craigyjp/Stratus---Pulse/Schematics/Front_Panel_Pots_&_Buttons.pdf

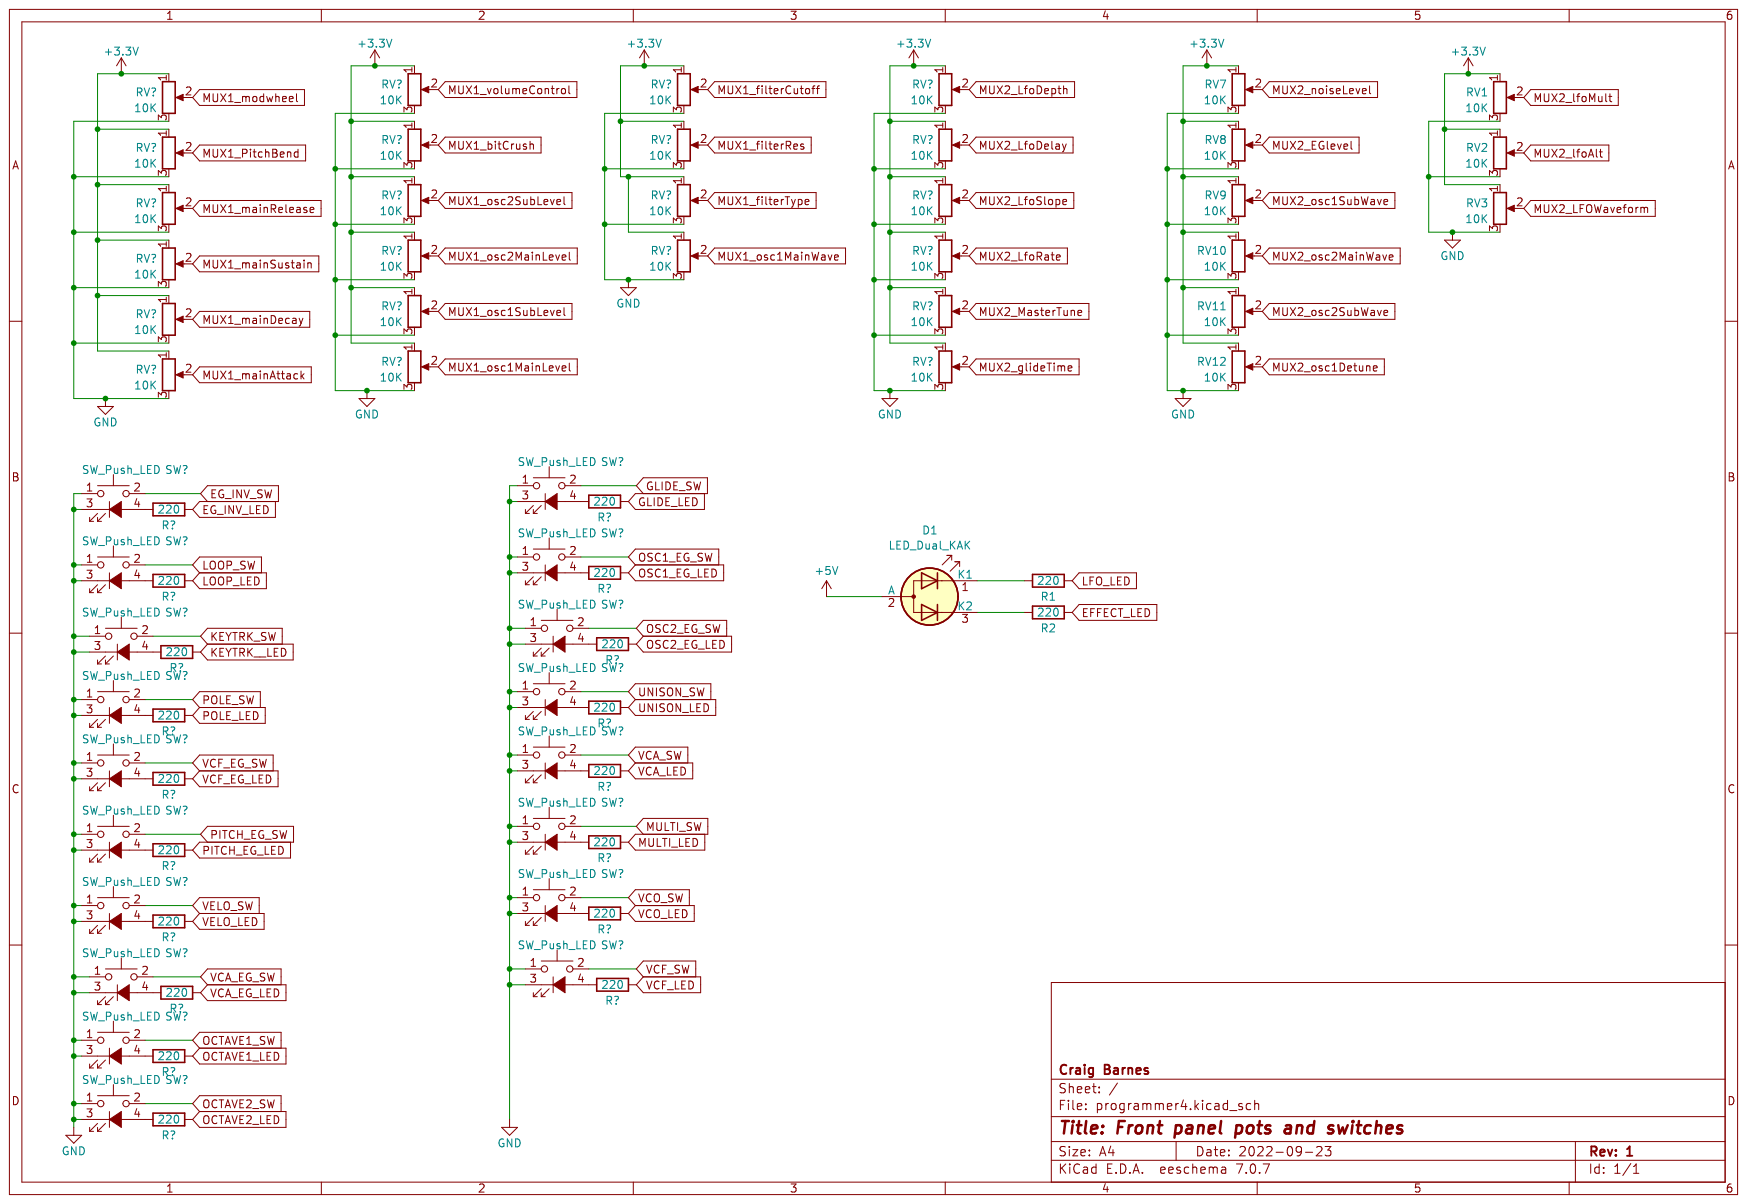
[picture p2: page 1]
