craigyjp/Stratus---Pulse/Schematics/Teensy_programmer.pdf

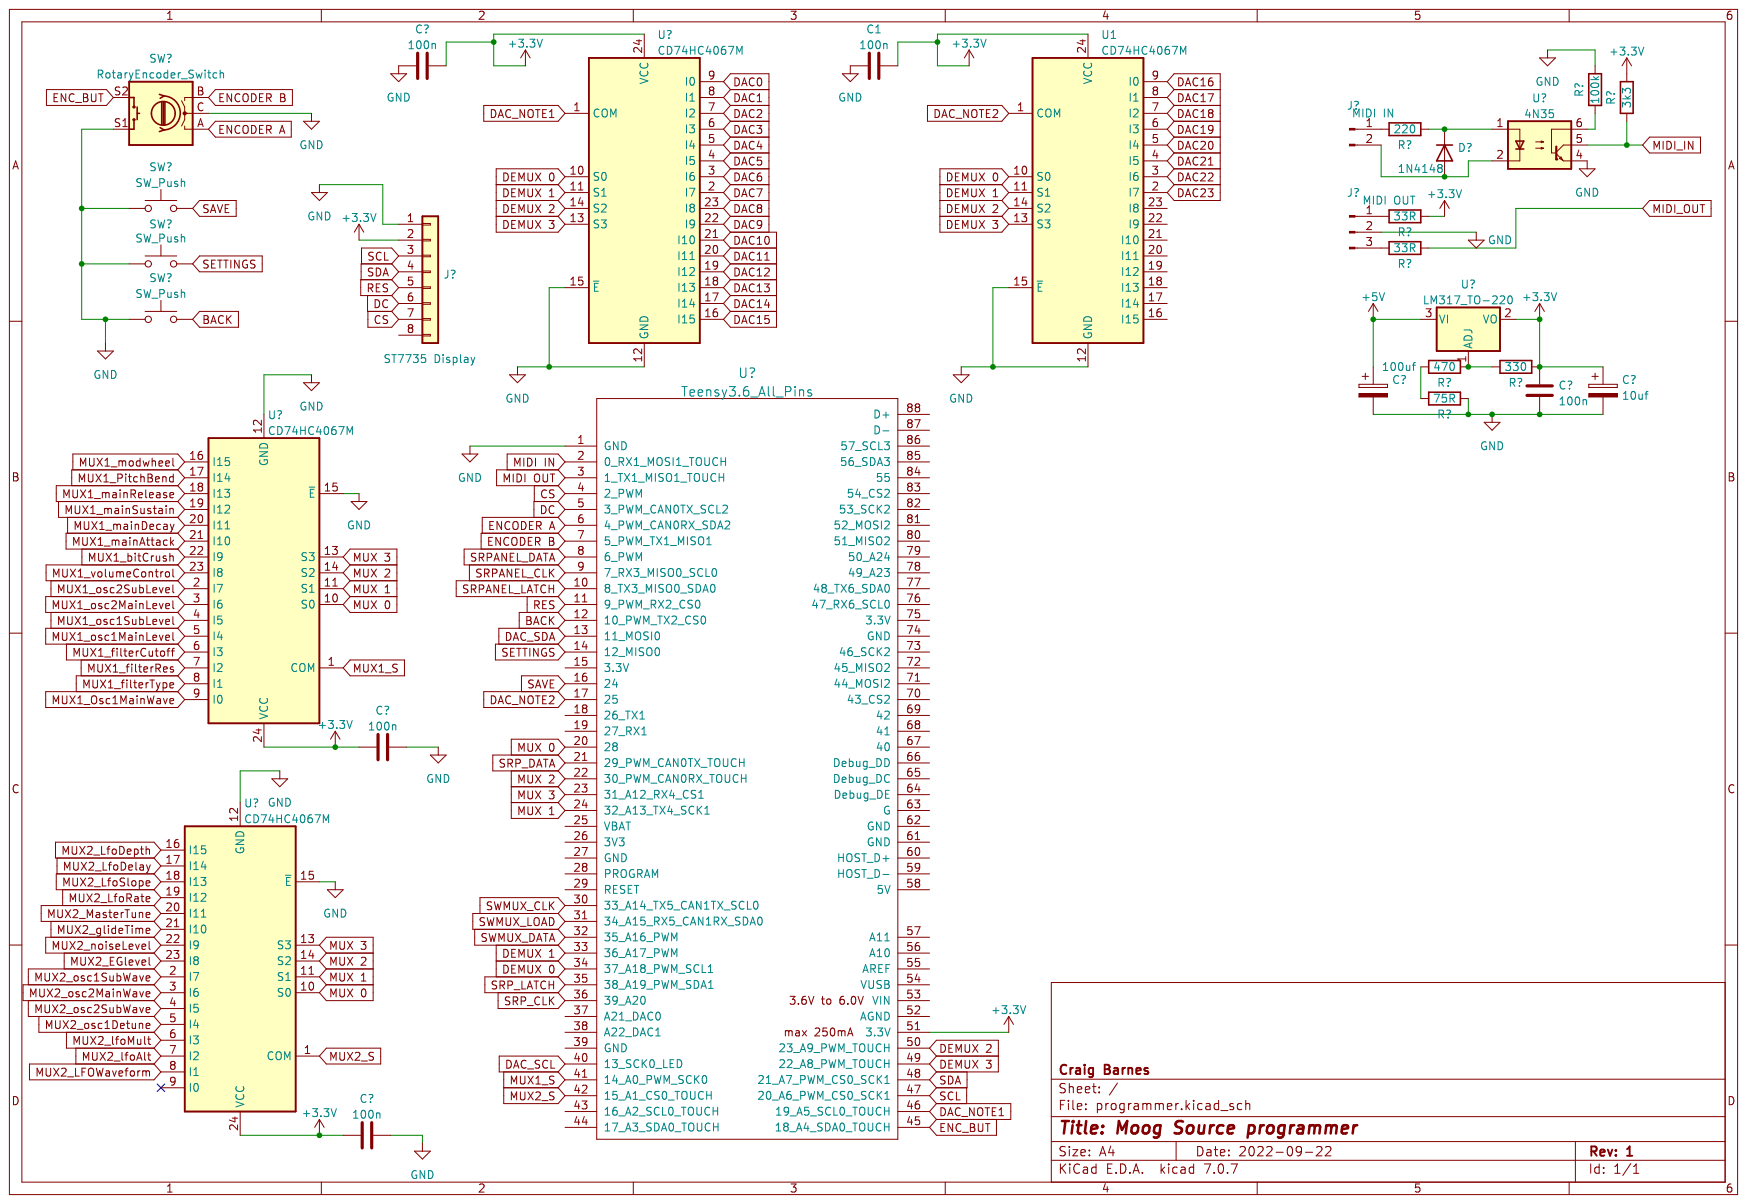
[picture p3: page 1]
