craigyjp/Stratus---Pulse/Schematics/595_&_165_shiftregisters.pdf

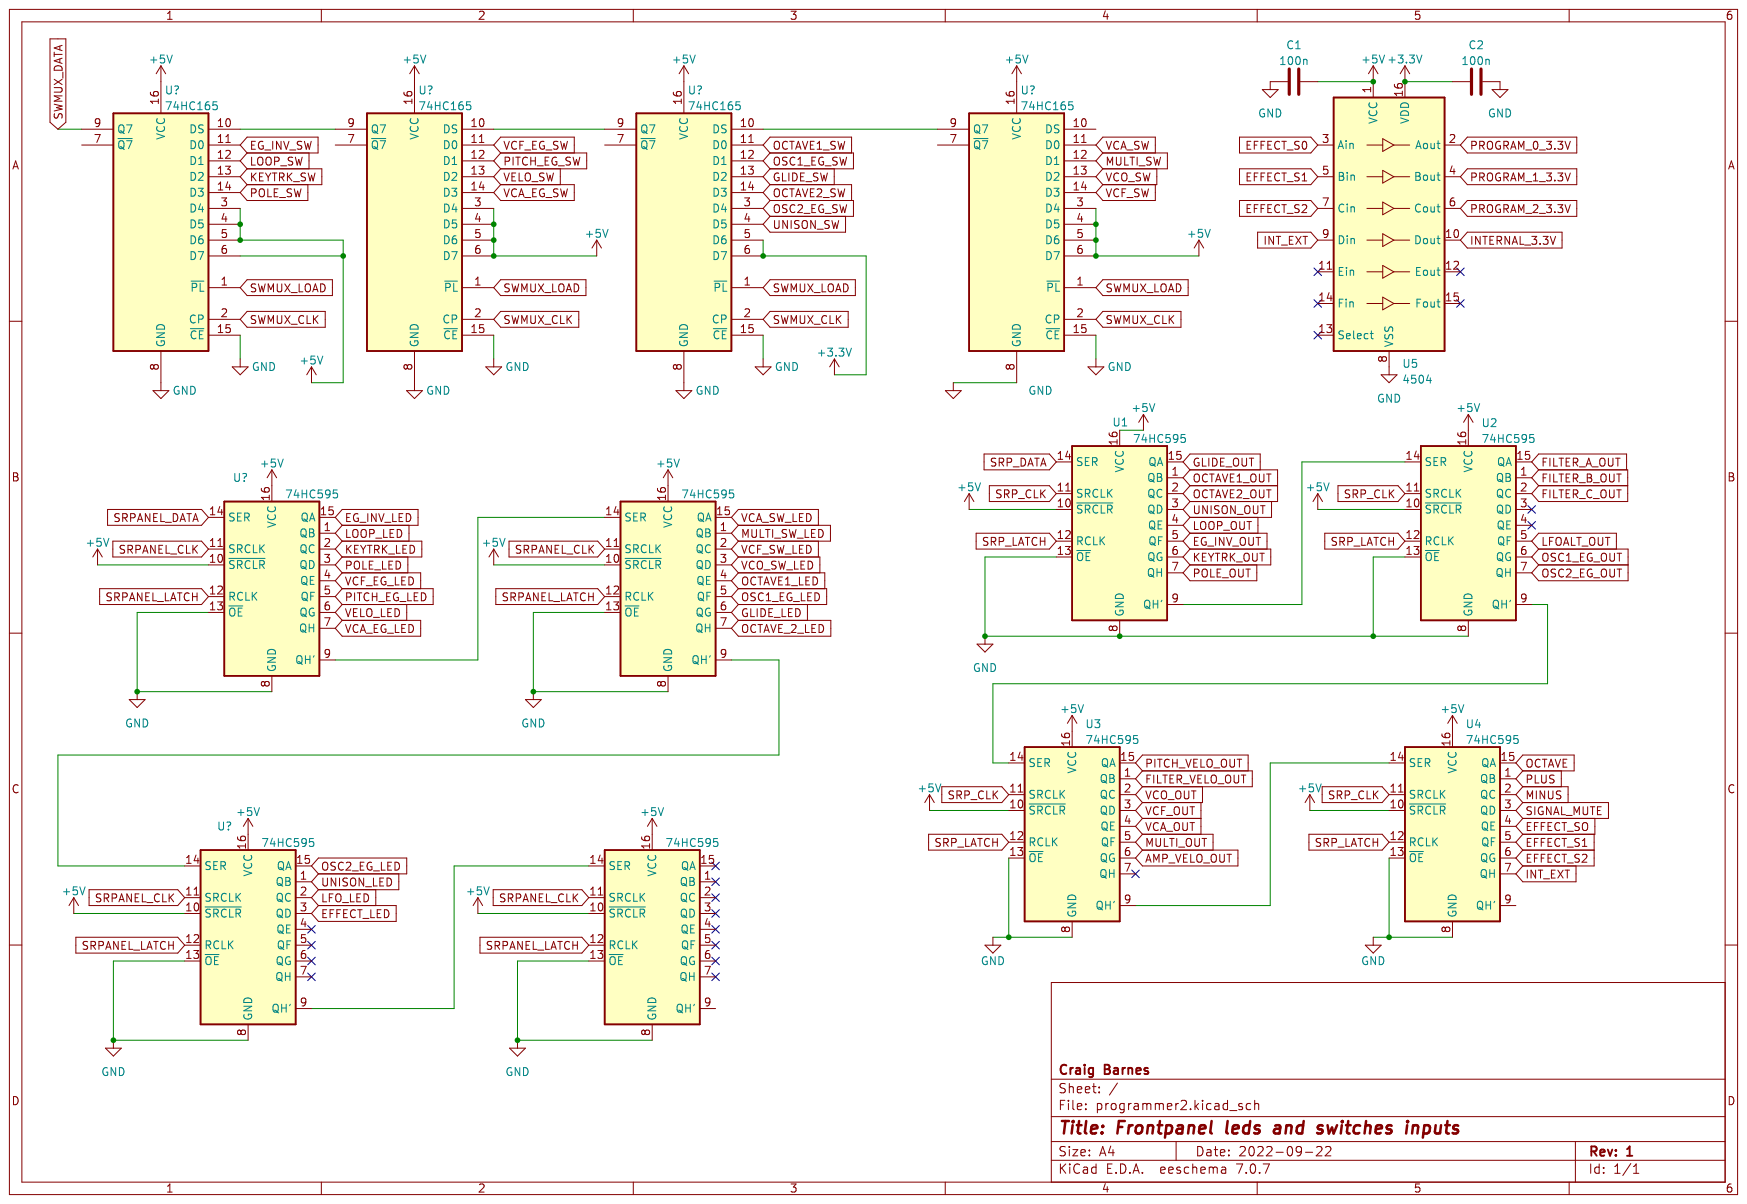
[picture p4: page 1]
