craigyjp/Stratus---Pulse/Schematics/FV-1 board.pdf

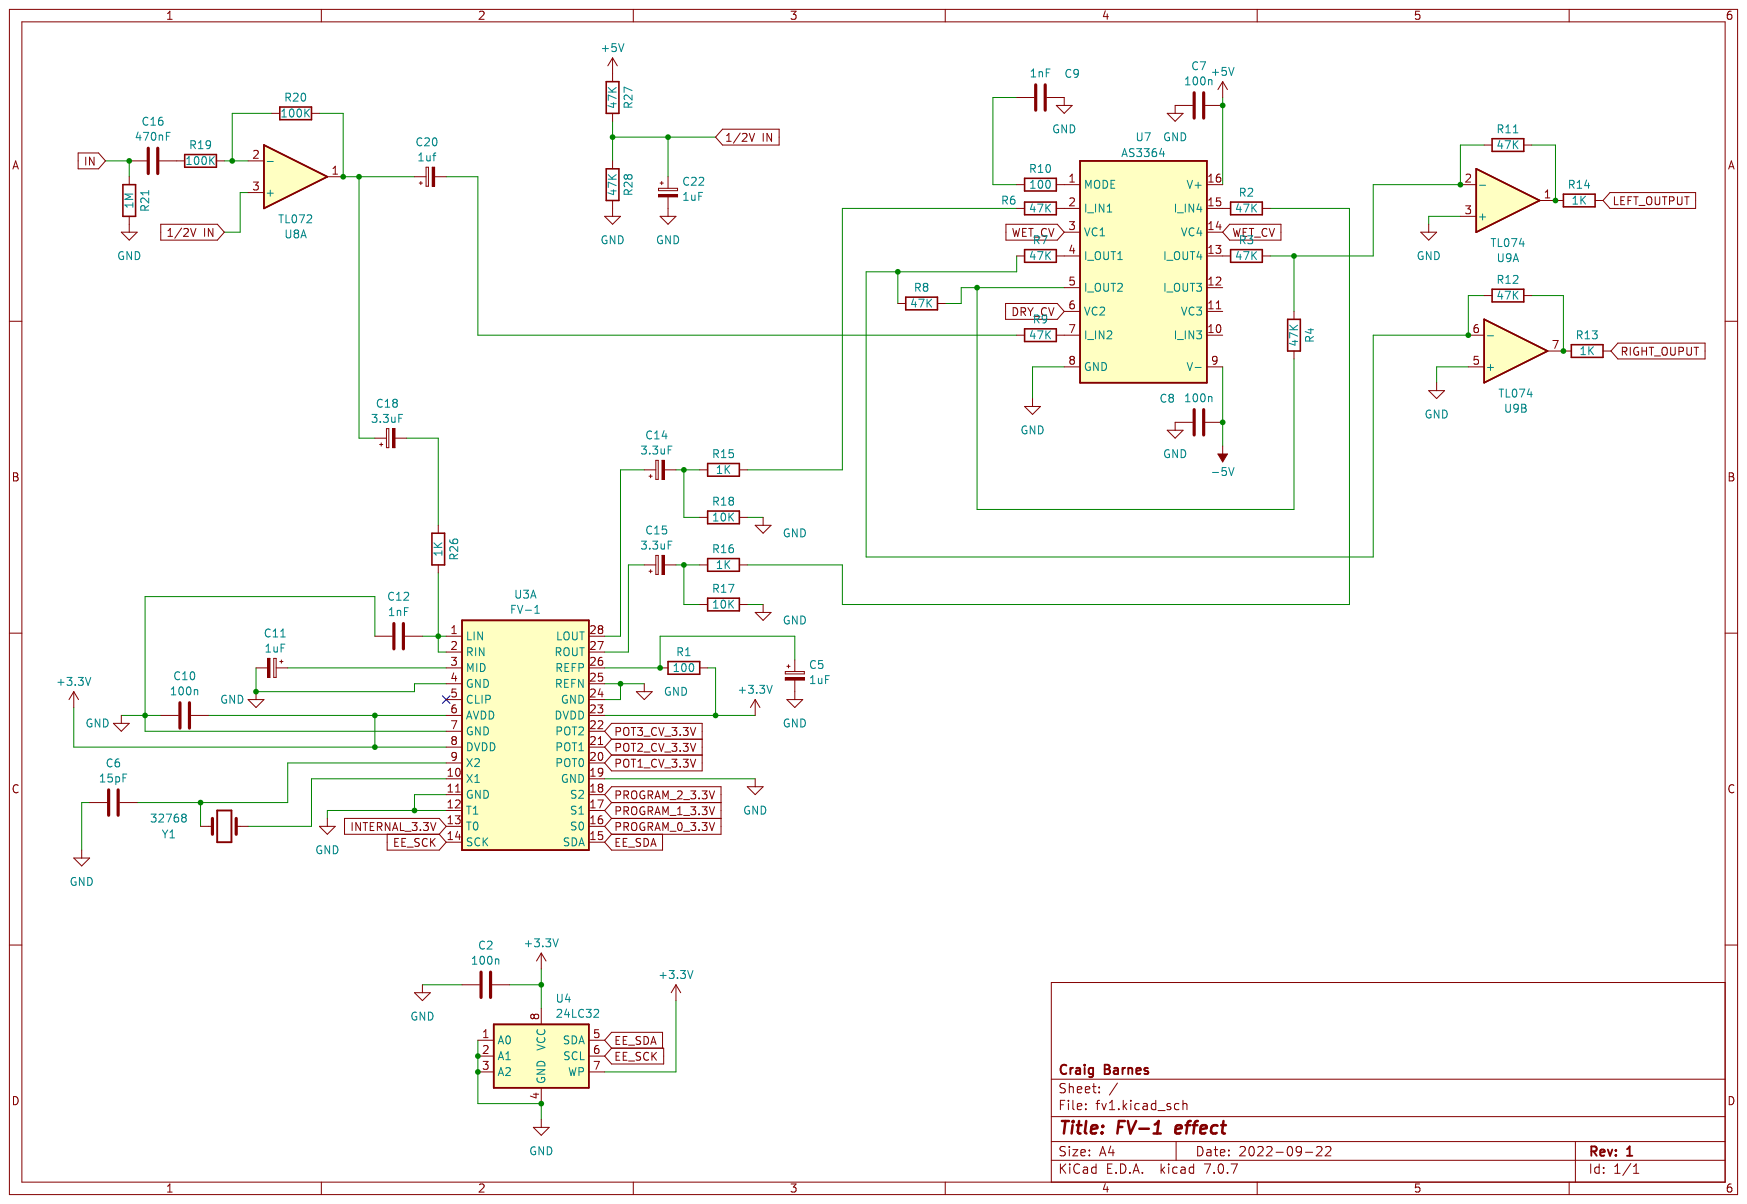
[picture p5: page 1]
