craigyjp/Stratus---Pulse/Schematics/3320_MM_Filter-schema.pdf

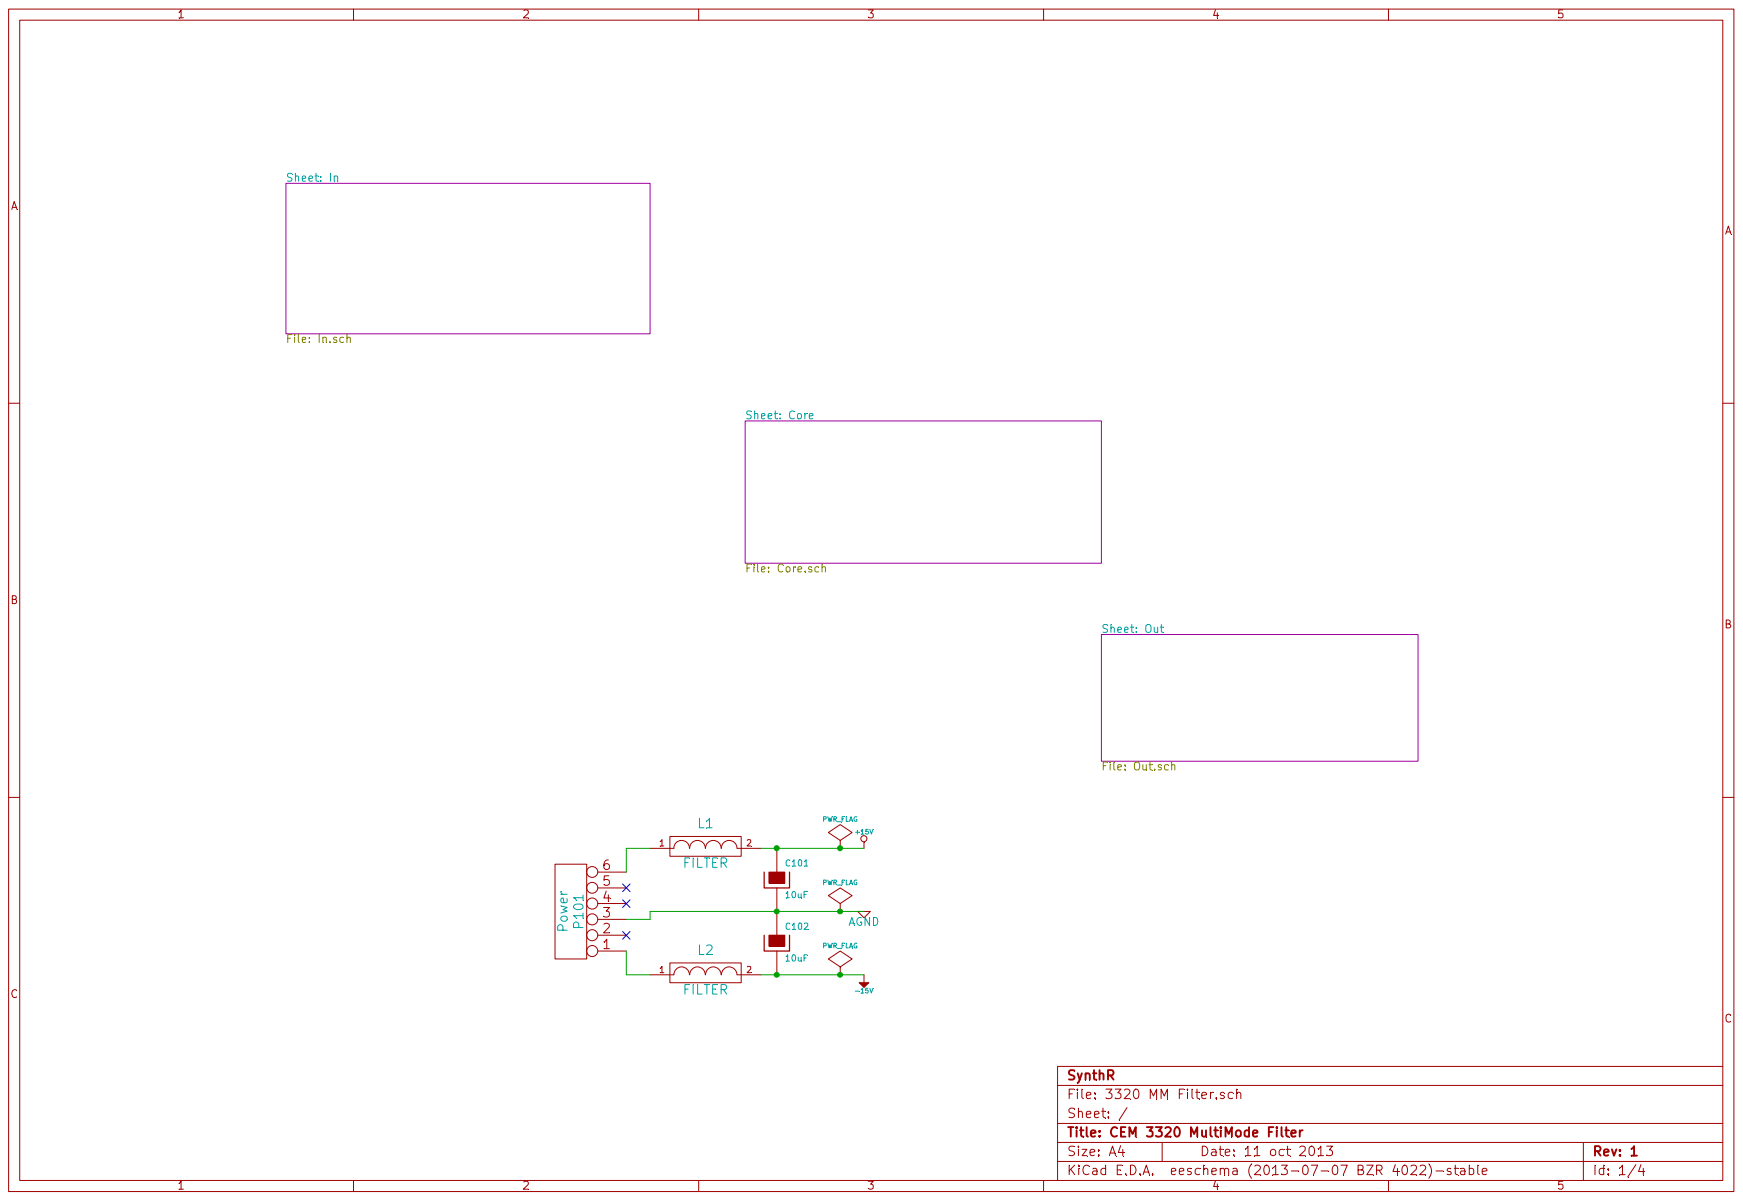
[picture p6: page 1]

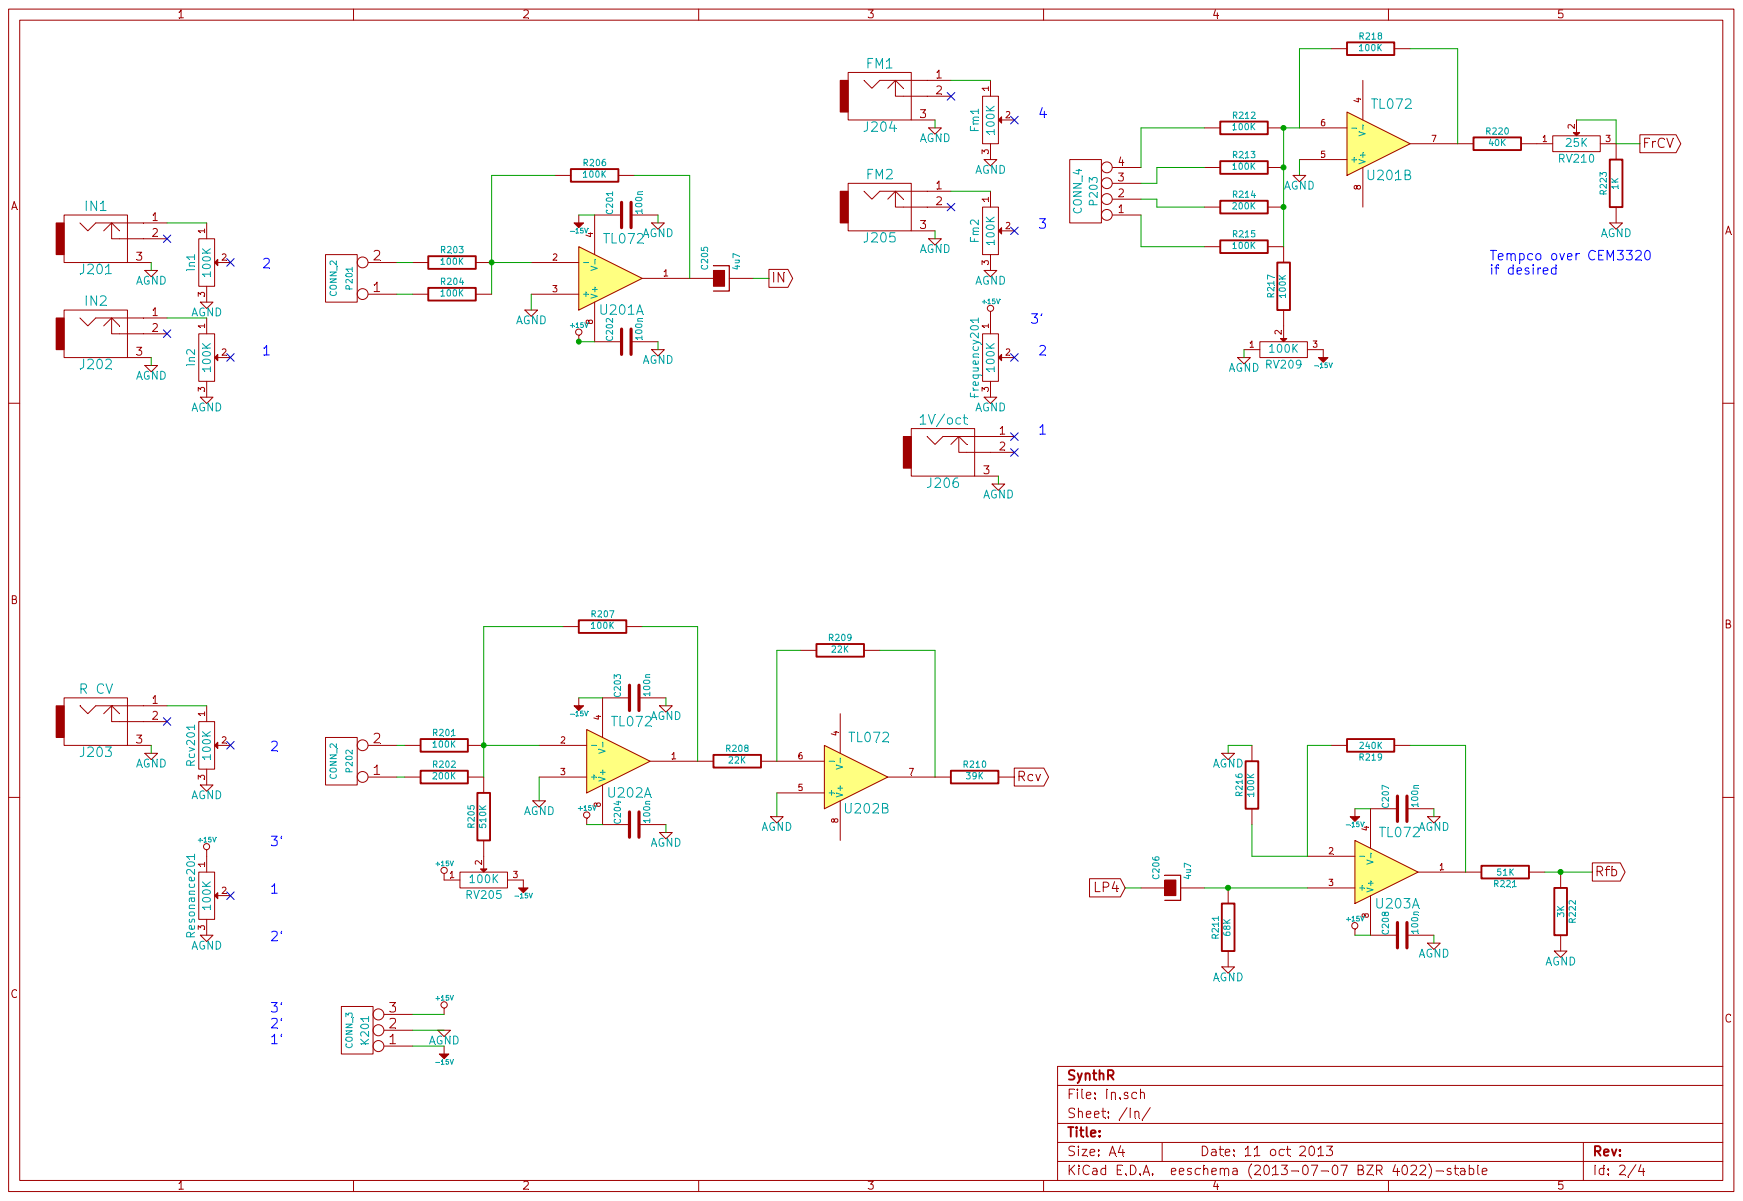
[picture p7: page 2]

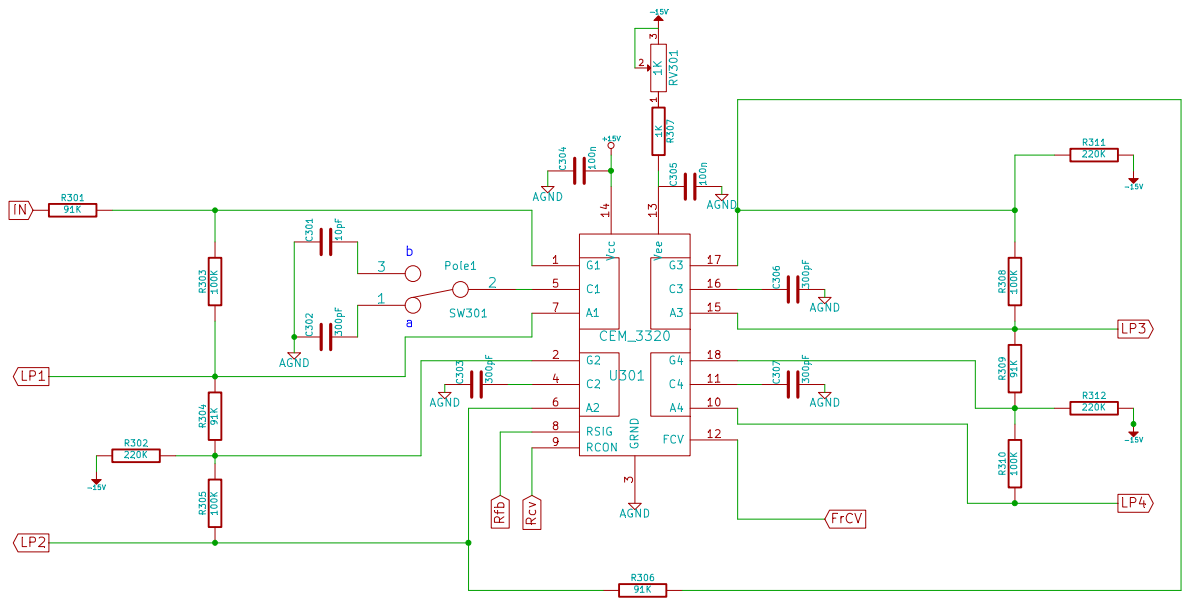
[picture p8: page 3]

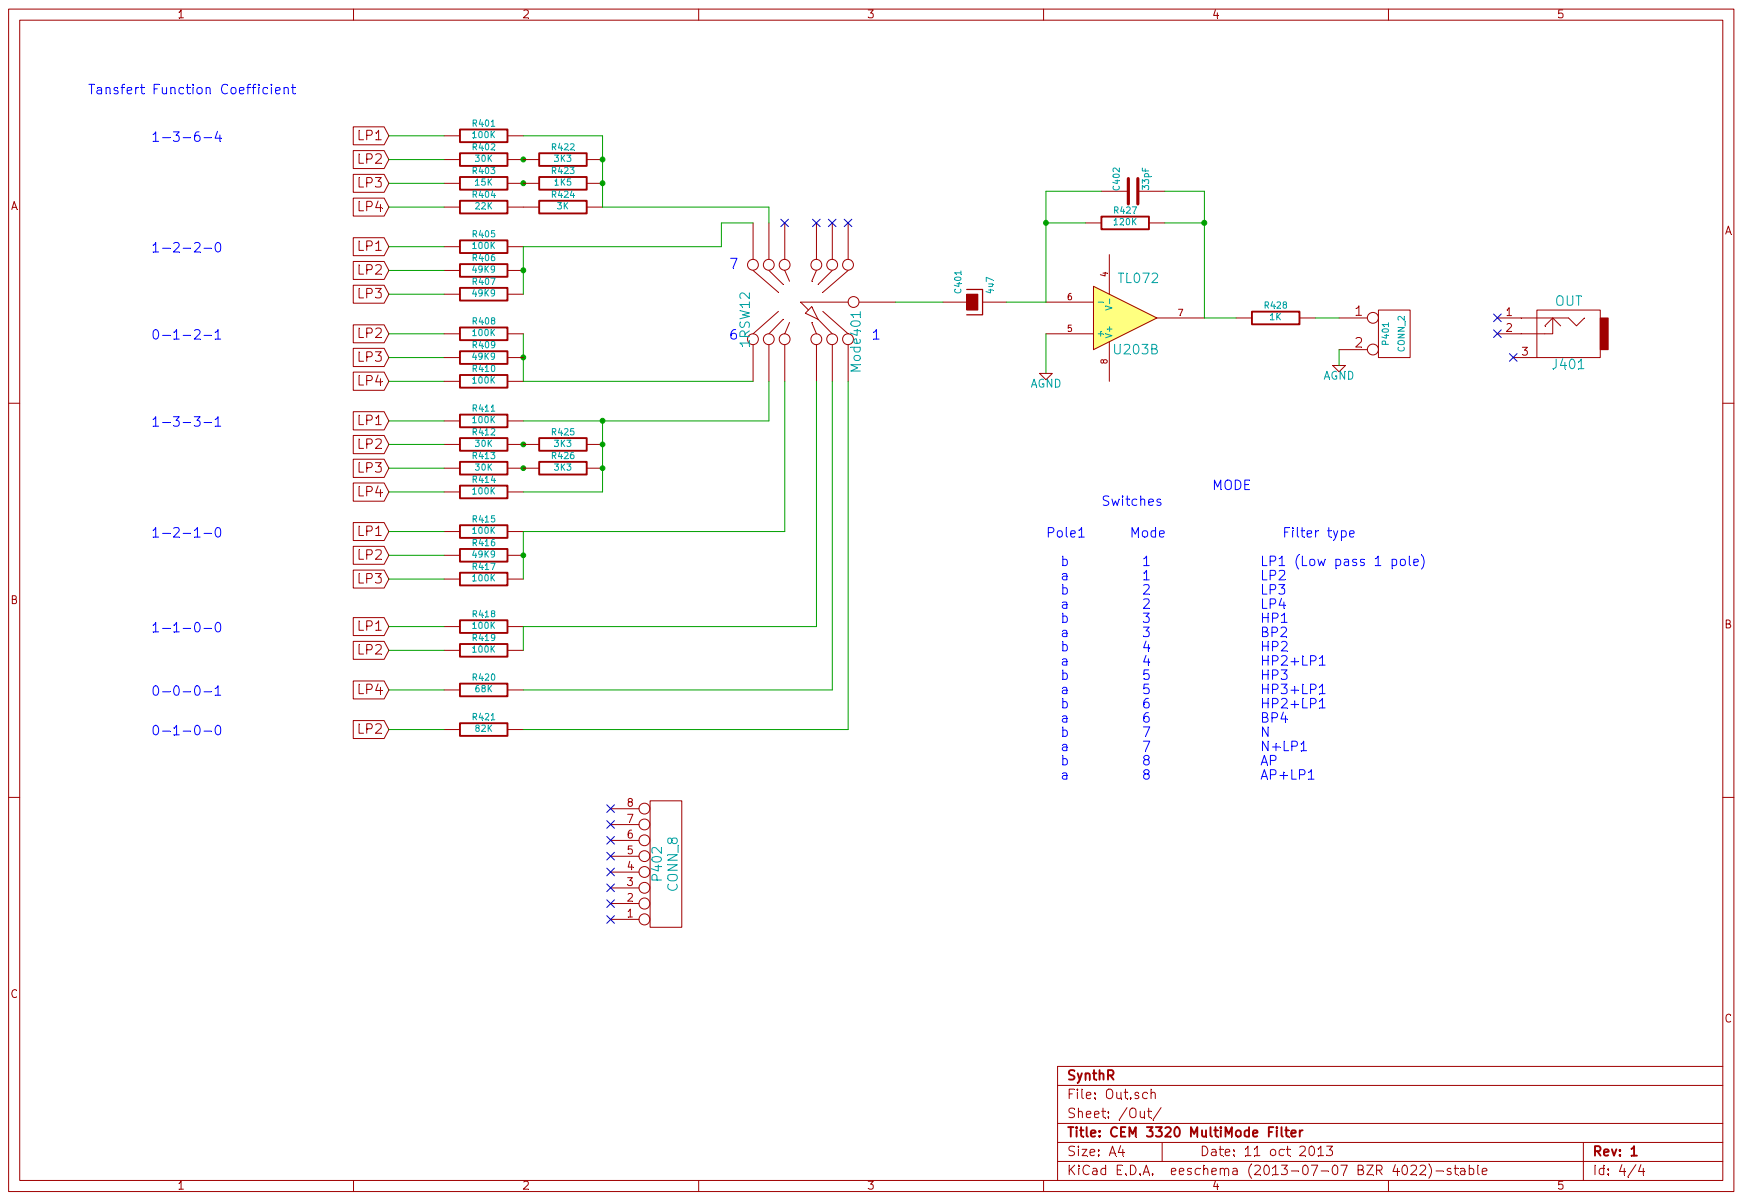
[picture p9: page 4]
