craigyjp/Stratus---Pulse/src/Constants.h

const char* VERSION = "V1.5";
const float FILTERCUTOFF[128] = {20, 23, 26, 29, 32, 36, 40, 46, 53, 60, 69, 78, 87, 98, 109, 120, 132, 145, 157, 171, 186, 200, 215, 231, 247, 264, 282, 300, 319, 338, 357, 378, 399, 421, 444, 467, 491, 516, 541, 567, 594, 621, 650, 680, 710, 741, 774, 806, 841, 876, 912, 949, 987, 1027, 1068, 1110, 1152, 1196, 1242, 1290, 1338, 1388, 1439, 1491, 1547, 1603, 1661, 1723, 1783, 1843, 1915, 1975, 2047, 2119, 2191, 2263, 2347, 2419, 2503, 2587, 2683, 2767, 2863, 2959, 3055, 3163, 3259, 3367, 3487, 3595, 3715, 3835, 3967, 4099, 4231, 4363, 4507, 4663, 4807, 4963, 5131, 5287, 5467, 5635, 5815, 6007, 6199, 6403, 6607, 6823, 7039, 7267, 7495, 7735, 7987, 8239, 8503, 8779, 9055, 9343, 9643, 9955, 10267, 10603, 10939, 11287, 11647, 12000};
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
#define PITCHLFOOCTAVERANGE 2.0f//2 Oct range
#define RE_READ -9
#define LFOMAXRATE 40.0f//40Hz
#define ONE 1.0f
#define GLIDEFACTOR 5000.0f//Maximum glide time
#define NO_OF_VOICES 6
#define NO_OF_PARAMS 80
const char* INITPATCHNAME = "Initial Patch";
#define HOLD_DURATION 1000
#define PATCHES_LIMIT 999
const uint32_t CLICK_DURATION = 250;
const String INITPATCH = "Solina,1,1,1,1,1,1,1,1,1,10,1,1,1,1,1,1,1,1,1,10,1,1,1,1,1,1,1,1,1,10,1,1,1,1,1,1,1,1,1,10,1,1,1,1,1,1,1";
