craigyjp/Stratus---Pulse/src/MidiCC.h

//MIDI CC control numbers
//These broadly follow standard CC assignments
#define   CCmodwheel  1 //pitch LFO amount - less from mod wheel
#define   CCLfoDepth  3 //pitch LFO amount - panel control
#define   CCGlideTime 5
#define   CCvolumeControl  7
#define   CCADSRInvert  15
#define   CCosc1MainWave 16
#define   CCosc2MainWave  17
#define   CCosc1SubWave  18
#define   CCosc2SubWave 19
#define   CCvelocitySW 20
#define   CCnoiseLevel  23
#define   CCunisonSW 24  //Off/On
#define   CCPitchrelease  25
#define   CCPitchattack 26
#define   CCPitchsustain  27
#define   CCPitchdecay  28
#define   CCPitchlevel  29
#define   CCoctave2  30 //Off/On
#define   CCglide  31 //Off/On
#define   CCpitchvelo  32
#define   CCpitchEG 33
#define   CClfoDestVCF 35
#define   CClfoDestVCA 36
#define   CCmonoMulti 37
#define   CClfoMult 38
#define   CCfilterType 39
#define   CClfoDestVCO 40
#define   CCfilterKeyTrack 43
#define   CCrilterRelease  44
#define   CCfilterAttack 45
#define   CCfilterSustain  46
#define   CCfilterDecay  47
#define   CCfilterLevel  48
#define   CCfilterVelo  49
#define   CCfilterEGinv  50
#define   CCfilterPole 51
#define   CCfilterLoop  52
#define   CCfilterEG  53
#define   CCeffects  54
#define   CCpot1 55
#define   CCpot2 56
#define   CCpot3 57
#define   CCeffectNumber 58
#define   CCmix 59
#define   CCinternal 60
#define   CCPitchBend 65
#define   CCLfoSlope 66
#define   CCAmplevel  67
#define   CCAmpvelo  68
#define   CCosc1EGinv  69
#define   CCosc2EGon  70
#define   CCosc1Detune 71
#define   CCamprelease  72
#define   CCampattack 73
#define   CCfilterCutoff  74
#define   CCampdecay  75
#define   CClfoAlt  76
#define   CCLfoRate 77
#define   CCampsustain  79
#define   CCosc1SubLevel 80
#define   CCosc1MainLevel  81
#define   CCampEG 82
#define   CCoctaveup 83
#define   CCoctavedown 84
#define   CCEGlevel 86
#define   CCLfoDelay  88 //MIDI Only
#define   CCkeytracking 89
#define   CCbitCrush  90
#define   CCLFOWaveform  91
#define   CCMasterTune  93
#define   CCfilterRes  94
#define   CCmainAttack  95
#define   CCmainDecay  96
#define   CCmainSustain  97
#define   CCmainRelease 98
#define   CCosc2SubLevel  102
#define   CCosc2MainLevel  103
#define   CCallnotesoff 123 //Panic button
#define   CCoctave1  126 //Off/On
