craigyjp/Stratus---Pulse/(commit log)

2023-11-11 Added FV-1 effects board and controls
2023-11-12 Fixed LFO waveform selection
    [Stratus.ino]
2023-11-12 Added filter schematics
2023-11-12 Added effects board
2023-11-12 Added LED drivers and buttons
2023-11-12 Added Teensy programmer
2023-11-12 Added pots and buttons
